othermod/DPI-Topper-3/boards/1.0.1/sch/sch.png

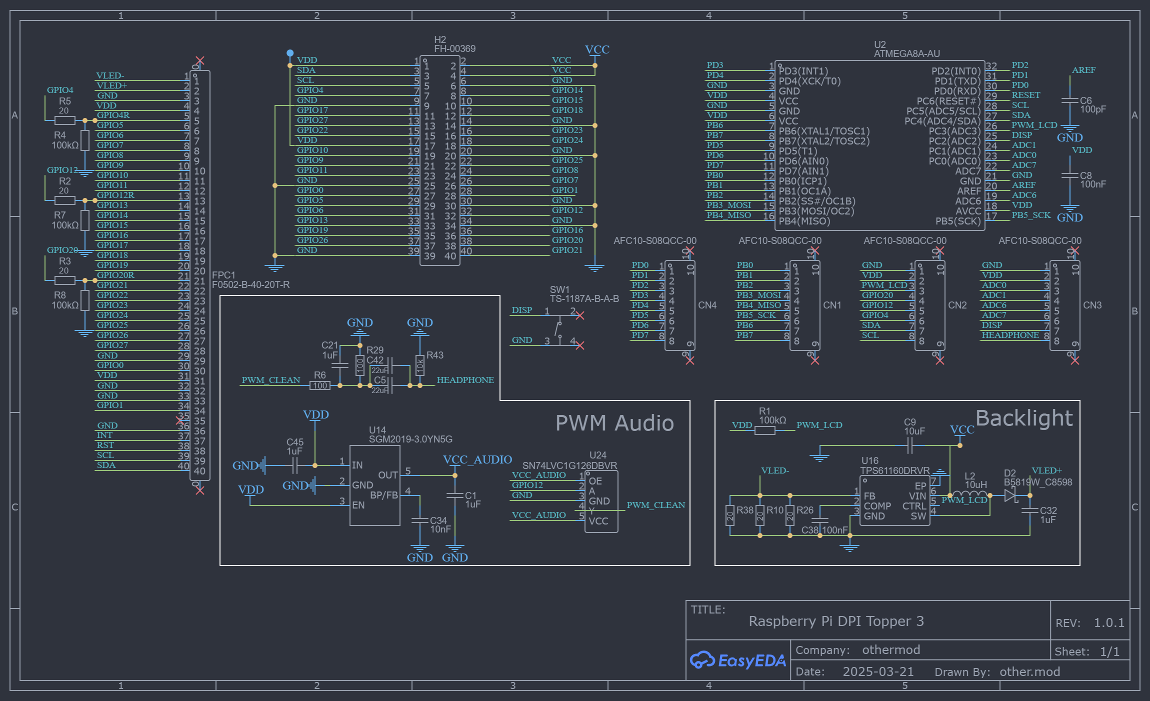
boards/1.0.1/sch/sch.png
