othermod/DPI-Topper-3/boards/1.0/pcb/variant_display.png

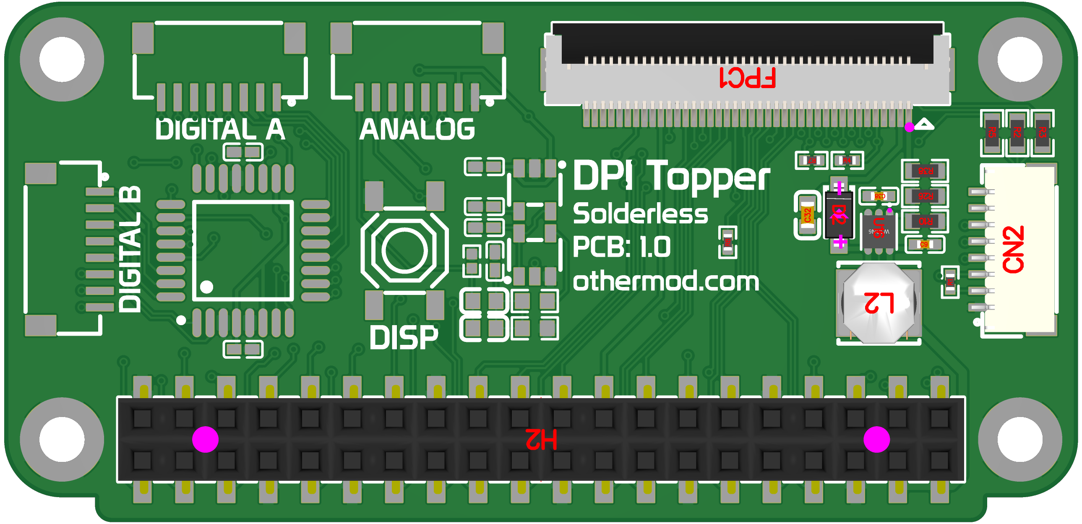
boards/1.0/pcb/variant_display.png
