othermod/DPI-Topper-3/boards/1.0/pcb/variant_gamepad.png

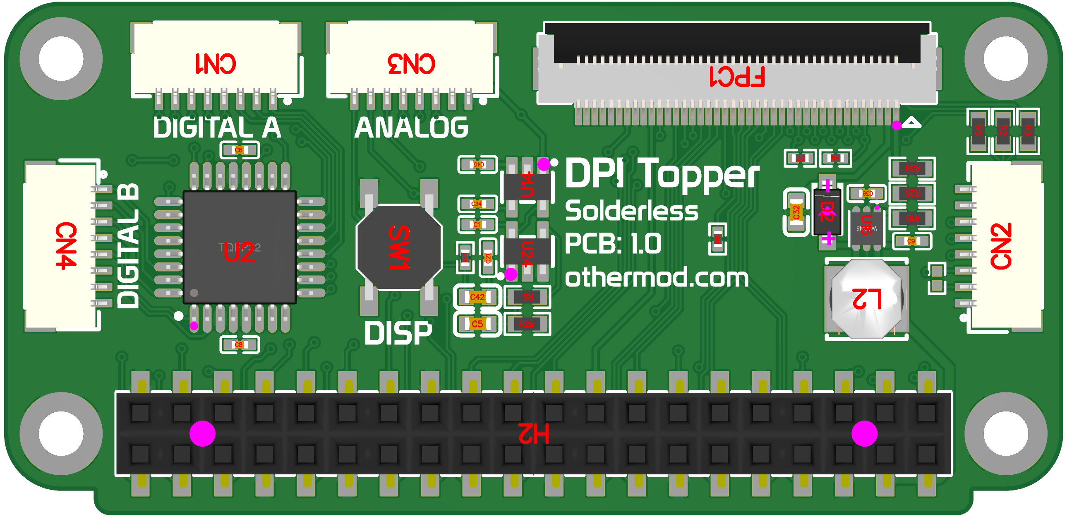
boards/1.0/pcb/variant_gamepad.png
