othermod/DPI-Topper-3/boards/1.0/pcb/bom/bom_display.csv

ID | Name | Designator | Footprint | Quantity | Manufacturer Part | Manufacturer | Supplier | Supplier Part | Price
1 | 100kΩ | R4,R7,R8,R1 | R0402 | 4 | 0402WGF1003TCE | UNI-ROYAL(厚声) | LCSC | C25741 | 0.001
3 | 20 | R2,R3,R5,R10,R26,R38 | R0603 | 6 | 0603WAF200JT5E | UNI-ROYAL(厚声) | LCSC | C22950 | 0.001
11 | 100nF | C38 | C0402 | 1 | CL05B104KO5NNNC | SAMSUNG(三星) | LCSC | C1525 | 0.001
12 | F0502-B-40-20T-R | FPC1 | FPC-SMD_40P-P0.50_L5.9-W24.4 | 1 | F0502-B-40-20T-R | XFCN(兴飞) | LCSC | C481222 | 0.135
15 | 10uF | C9 | C0402 | 1 | CL05A106MQ5NUNC | SAMSUNG(三星) | LCSC | C15525 | 0.004
16 | 1uF | C32 | C0603 | 1 | CL10A105KB8NNNC | SAMSUNG(三星) | LCSC | C15849 | 0.004
17 | B5819W_C8598 | D2 | SOD-123_L2.7-W1.6-LS3.7-RD-1 | 1 | B5819W SL | CJ(江苏长电/长晶) | LCSC | C8598 | 0.026
18 | 10uH | L2 | IND-SMD_L4.9-W4.9_NRS50XX | 1 | NRS5010T100MMGF | TAIYO YUDEN(太诱) | LCSC | C222896 | 0.185
19 | TPS61160DRVR | U16 | WSON-6_L2.0-W2.0-P0.65-TL-EP | 1 | TPS61160DRVR | TI(德州仪器) | LCSC | C165143 | 0.497
20 | AFC10-S08QCC-00 | CN2 | CONN-SMD_AFC10-S08QCC-00 | 4 | AFC10-S08QCC-00 | JS(钜硕电子) | LCSC | C395305 | 0.104
21 | FH-00369 | H2 | CONN-SMD_FH-00369 | 1 | FH-00369 | Liansheng(连盛) | LCSC | C2685115 | 0.648
