othermod/DPI-Topper-3/boards/1.0.1/pcb/soldered/bom/bom_gamepad_soldered.csv

ID | Name | Designator | Footprint | Quantity | Manufacturer Part | Manufacturer | Supplier | Supplier Part | Price
1 | 100kΩ | R4,R7,R8 | R0402 | 4 | 0402WGF1003TCE | UNI-ROYAL(厚声) | LCSC | C25741 | 0.001
2 | 1uF | C45,C1,C21 | C0402 | 3 | CL05A105KA5NQNC | SAMSUNG(三星) | LCSC | C52923 | 0.003
3 | 20 | R2,R3,R5,R10,R26,R38 | R0603 | 6 | 0603WAF200JT5E | UNI-ROYAL(厚声) | LCSC | C22950 | 0.001
4 | 22uF | C5,C42 | C0603 | 2 | CL10A226MQ8NRNC | SAMSUNG(三星) | LCSC | C59461 | 0.008
5 | 10nF | C34 | C0402 | 1 | CL05B103KB5NNNC | SAMSUNG(三星) | LCSC | C15195 | 0.001
6 | 100 | R6,R29 | R0603 | 2 | 0603WAF1000T5E | UNI-ROYAL(厚声) | LCSC | C22775 | 0.001
7 | 10k | R43 | R0402 | 1 | 0402WGF1002TCE | UNI-ROYAL(厚声) | LCSC | C25744 | 0.001
8 | SGM2019-3.0YN5G | U14 | SOT-23-5_L3.0-W1.7-P0.95-LS2.8-BR | 1 | SGM2019-3.0YN5G/TR | SGMICRO(圣邦微) | LCSC | C57079 | 0.074
9 | SN74LVC1G126DBVR | U24 | SOT-23-5_L3.0-W1.7-P0.95-LS2.8-BR | 1 | SN74LVC1G126DBVR | TI(德州仪器) | LCSC | C7834 | 0.057
10 | TS-1187A-B-A-B | SW1 | SW-SMD_4P-L5.1-W5.1-P3.70-LS6.5-TL-2 | 1 | TS-1187A-B-A-B | XKB Connectivity(中国星坤) | LCSC | C318884 | 0.02
11 | 100nF | C38 | C0402 | 1 | CL05B104KO5NNNC | SAMSUNG(三星) | LCSC | C1525 | 0.001
12 | F0502-B-40-20T-R | FPC1 | FPC-SMD_40P-P0.50_L5.9-W24.4 | 1 | F0502-B-40-20T-R | XFCN(兴飞) | LCSC | C481222 | 0.135
13 | 100pF | C6 | C0402 | 1 | 0402CG101J500NT | FH(风华) | LCSC | C1546 | 0.001
14 | 100nF | C8 | C0402 | 1 | CL05B104KB54PNC | SAMSUNG(三星) | LCSC | C307331 | 0.005
15 | 10uF | C9 | C0402 | 1 | CL05A106MQ5NUNC | SAMSUNG(三星) | LCSC | C15525 | 0.004
16 | 1uF | C32 | C0603 | 1 | CL10A105KB8NNNC | SAMSUNG(三星) | LCSC | C15849 | 0.004
17 | B5819W_C8598 | D2 | SOD-123_L2.7-W1.6-LS3.7-RD-1 | 1 | B5819W SL | CJ(江苏长电/长晶) | LCSC | C8598 | 0.026
18 | 10uH | L2 | IND-SMD_L4.9-W4.9_NRS50XX | 1 | NRS5010T100MMGF | TAIYO YUDEN(太诱) | LCSC | C222896 | 0.185
19 | TPS61160DRVR | U16 | WSON-6_L2.0-W2.0-P0.65-TL-EP | 1 | TPS61160DRVR | TI(德州仪器) | LCSC | C165143 | 0.497
20 | AFC10-S08QCC-00 | CN2,CN4,CN3,CN1 | CONN-SMD_AFC10-S08QCC-00 | 4 | AFC10-S08QCC-00 | JS(钜硕电子) | LCSC | C395305 | 0.104
22 | ATMEGA8A-AU | U2 | TQFP-32_L7.0-W7.0-P0.80-LS9.0-BL | 1 | ATMEGA8A-AU | MICROCHIP(美国微芯) | LCSC | C16190 | 2.03
