othermod/DPI-Topper-3/boards/1.0.1/pcb/soldered/variant_display_soldered.png

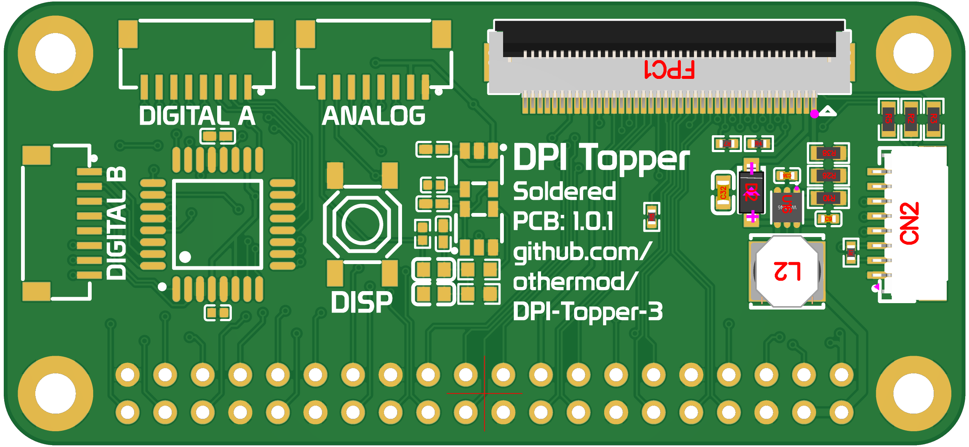
boards/1.0.1/pcb/soldered/variant_display_soldered.png
