othermod/DPI-Topper-3/boards/1.0.1/pcb/solderless/variant_display_solderless.png

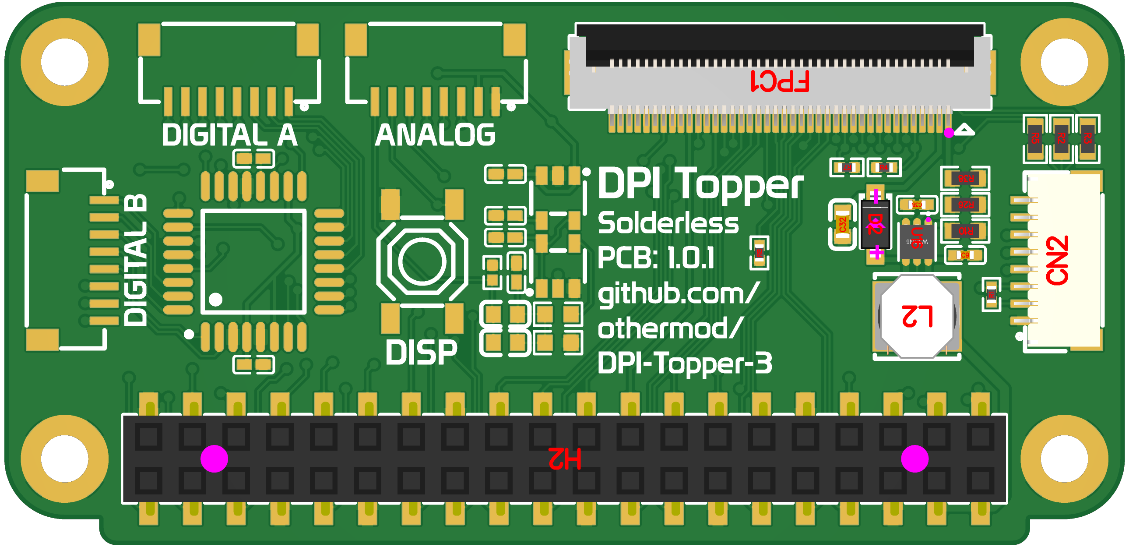
boards/1.0.1/pcb/solderless/variant_display_solderless.png
