othermod/DPI-Topper-3/(list of files, drawings)

Other design files:
boards/1.0.1/pcb/solder/pcb_easyeda.json
boards/1.0.1/pcb/soldered/pcb_easyeda_soldered.json
boards/1.0.1/pcb/solderless/pcb_easyeda_solderless.json
boards/1.0.1/sch/sch_easyeda.json
boards/1.0/pcb/pcb_easyeda.json
boards/1.0/pcb/sch_easyeda.json
