othermod/DPI-Topper-3/atmega/bootloader/bootloader.c

/*
 * TWI/I2C Bootloader for ATmega8
 * Concept inspired by twiboot by Olaf Rempel <razzor@kopf-tisch.de>
 */

#include <avr/io.h>
#include <avr/boot.h>
#include <avr/pgmspace.h>

#define BOOTLOADER_VERSION          0x01
#define TWI_ADDRESS                 0x29

/* Timer0: F_CPU / 1024, free-running overflow period = 256 * 1024 / F_CPU */
#define TIMER_DIVISOR               1024
#define TIMER_OVF_PER_SEC           (F_CPU / ((uint32_t)TIMER_DIVISOR * 256))

/* I2C protocol commands */
#define CMD_READ_INFO               0x01
#define CMD_WRITE_PAGE              0x03  /* page number byte precedes the 64 data bytes */
#define CMD_FINALIZE                0x05

/* TWI slave receiver status codes (ATmega8 datasheet table 22-2) */
#define TWI_SR_SLA_ACK              0x60    /* SLA+W received, ACK returned */
#define TWI_SR_DATA_ACK             0x80    /* data received, ACK returned */
#define TWI_SR_DATA_NACK            0x88    /* data received, NACK returned */
#define TWI_SR_STOP                 0xA0    /* STOP or repeated START received */

/* TWI slave transmitter status codes (ATmega8 datasheet table 22-3) */
#define TWI_ST_SLA_ACK              0xA8    /* SLA+R received, ACK returned */
#define TWI_ST_DATA_ACK             0xB8    /* data sent, ACK received */
#define TWI_ST_DATA_NACK            0xC0    /* data sent, NACK received */
#define TWI_ST_LAST_ACK             0xC8    /* last data byte sent, ACK received */

/* bootloader run modes */
#define BL_HOLD                     0x00
#define BL_JUMP_APP                 0x01

/* Verification status codes (bit patterns with Hamming distance 8 from each other) */
#define VERIFY_PENDING              0x00
#define VERIFY_FAILED               0x55
#define VERIFY_PASSED               0xAA

/* TWI ACK control helpers */
#define TWI_CLEAR_ACK(ctrl)         ((ctrl) &= ~(1<<TWEA))
#define TWI_SET_ACK(ctrl)           ((ctrl) |=  (1<<TWEA))

/* Pin definitions */
#define LCD_CONTROL                 (1<<PC3)
#define BTN_DISP                    (1<<PC2)

static uint8_t          bl_mode                  = BL_HOLD;
static uint8_t          page_buf[SPM_PAGESIZE];
static uint16_t         flash_addr;
static volatile uint8_t page_write_pending       = 0;
static volatile uint8_t page_write_ready         = 0;
static volatile uint8_t checksum_verify_pending  = 0;
static uint8_t          verify_status            = VERIFY_PENDING;
static uint8_t          info_bytes[6];
static uint8_t          info_checksum[3];


static void write_flash_page(void)
{
    uint16_t pagestart = flash_addr;
    uint16_t fill_addr = flash_addr;
    uint8_t  i;

    boot_page_erase(pagestart);
    boot_spm_busy_wait();

    for (i = 0; i < SPM_PAGESIZE; i += 2)
    {
        uint16_t word = page_buf[i] | ((uint16_t)page_buf[i + 1] << 8);
        boot_page_fill(fill_addr, word);
        fill_addr += 2;
    }

    boot_page_write(pagestart);
    boot_spm_busy_wait();
    boot_rww_enable();
}


static void update_info_checksum(void)
{
    uint8_t sum1 = 0, sum2 = 0, xor = 0, i;
    for (i = 0; i < 6; i++)
    {
        sum1 += info_bytes[i];
        sum2 += sum1;
        xor  ^= info_bytes[i];
    }
    info_checksum[0] = sum1;
    info_checksum[1] = sum2;
    info_checksum[2] = xor;
}


/* Checksum covers all app flash bytes except the final 3, which store the checksum itself. */
static void compute_flash_checksum(uint8_t *f16_a, uint8_t *f16_b, uint8_t *xorsum)
{
    uint8_t  sum1 = 0, sum2 = 0, xor = 0;
    uint16_t i;
    for (i = 0; i < BOOTLOADER_START - 3; i++)
    {
        uint8_t b = pgm_read_byte_near(i);
        sum1 += b;
        sum2 += sum1;
        xor  ^= b;
    }
    *f16_a  = sum1;
    *f16_b  = sum2;
    *xorsum = xor;
}


/* Returns 1 if the embedded checksum at the top of app flash matches the computed value. */
static uint8_t flash_verify_checksum(void)
{
    uint8_t f16_a, f16_b, xorsum;
    compute_flash_checksum(&f16_a, &f16_b, &xorsum);
    return (f16_a  == pgm_read_byte_near(BOOTLOADER_START - 3) &&
            f16_b  == pgm_read_byte_near(BOOTLOADER_START - 2) &&
            xorsum == pgm_read_byte_near(BOOTLOADER_START - 1));
}


static void twi_handle(void)
{
    static uint8_t cmd = 0;
    /* byte_cnt counts received bytes in the RX path and sent bytes in the TX path */
    static uint8_t byte_cnt;

    uint8_t twi_ctrl   = TWCR;
    uint8_t twi_status = TWSR & 0xF8;

    switch (twi_status)
    {
        case TWI_SR_SLA_ACK:
            byte_cnt           = 0;
            page_write_pending = 0;
            page_write_ready   = 0;
            break;

        case TWI_SR_DATA_ACK:
        {
            uint8_t rx_data = TWDR;

            if (byte_cnt == 0)
            {
                cmd = rx_data;
                switch (cmd)
                {
                    /* valid commands; no immediate action on receipt of command byte */
                    case CMD_READ_INFO:
                    case CMD_WRITE_PAGE:
                    case CMD_FINALIZE:
                        break;

                    default:
                        TWI_CLEAR_ACK(twi_ctrl);
                        break;
                }
            }
            else
            {
                switch (cmd)
                {
                    case CMD_WRITE_PAGE:
                        if (byte_cnt == 1)
                        {
                            /* first byte after command is the page number */
                            if (rx_data >= (BOOTLOADER_START / SPM_PAGESIZE))
                                TWI_CLEAR_ACK(twi_ctrl);
                            else
                                flash_addr = (uint16_t)rx_data * SPM_PAGESIZE;
                        }
                        else
                        {
                            uint8_t buf_pos = byte_cnt - 2;
                            page_buf[buf_pos] = rx_data;
                            if (buf_pos >= (SPM_PAGESIZE - 1))
                            {
                                page_write_pending = 1;
                                TWI_CLEAR_ACK(twi_ctrl);
                            }
                        }
                        break;

                    case CMD_FINALIZE:
                        /* no data bytes expected; NACK any extra */
                        TWI_CLEAR_ACK(twi_ctrl);
                        break;

                    default:
                        break;
                }
            }

            byte_cnt++;
            break;
        }

        /* master sent more data than expected; treat as end of transaction */
        case TWI_SR_DATA_NACK:
            /* fall through */

        case TWI_SR_STOP:
            if (page_write_pending)
            {
                /* STOP received with a pending write: set page_write_ready so the
                 * main loop starts the flash write only AFTER this TWINT is cleared.
                 * This prevents the ATmega from holding SCL during the 4.5ms
                 * erase+program cycle, which triggers the BCM2835 clock-stretch bug. */
                TWI_CLEAR_ACK(twi_ctrl);
                page_write_ready = 1;
            }
            else
            {
                if (cmd == CMD_FINALIZE && byte_cnt >= 1)
                {
                    checksum_verify_pending = 1;
                    /* Keep TWEA cleared while compute_flash_checksum runs (~7ms)
                     * in the main loop, for the same reason as above. */
                    TWI_CLEAR_ACK(twi_ctrl);
                }
                byte_cnt = 0;
                if (!checksum_verify_pending)
                    TWI_SET_ACK(twi_ctrl);
            }
            break;

        case TWI_ST_SLA_ACK:
            byte_cnt = 0;
            /* fall through */

        case TWI_ST_DATA_ACK:
        {
            uint8_t tx_data = 0xFF;

            switch (cmd)
            {
                case CMD_READ_INFO:
                    if (byte_cnt < 6)
                        tx_data = info_bytes[byte_cnt];
                    else if (byte_cnt < 9)
                        tx_data = info_checksum[byte_cnt - 6];
                    if (byte_cnt == 8)
                        TWI_CLEAR_ACK(twi_ctrl);
                    break;

                default:
                    break;
            }

            TWDR = tx_data;
            byte_cnt++;
            break;
        }

        case TWI_ST_DATA_NACK:
        case TWI_ST_LAST_ACK:
            TWI_SET_ACK(twi_ctrl);
            break;

        default:
            /* unexpected TWI state; set TWSTO to reset the bus */
            twi_ctrl |= (1<<TWSTO);
            break;
    }

    TWCR = (1<<TWINT) | twi_ctrl;
}


void init1(void) __attribute__((naked, section(".init1")));
void init1(void)
{
    asm volatile ("clr __zero_reg__");
    SP = RAMEND;
}


int main(void) __attribute__((OS_main, section(".init9")));
int main(void)
{
    /* explicitly re-init critical state rather than relying on .bss clearing */
    bl_mode            = BL_HOLD;
    page_write_pending = 0;
    page_write_ready   = 0;

    /* output, initially low, driven high when bootloader holds active */
    DDRC  |=  LCD_CONTROL;
    PORTC &= ~LCD_CONTROL;

    /* input with pull-up, held low at power-on forces bootloader to stay active */
    DDRC  &= ~BTN_DISP;
    PORTC |=  BTN_DISP;

    /* Timer0: F_CPU / 1024, free-running */
    TCCR0 = (1<<CS02) | (1<<CS00);

    /* TWI: set slave address, enable auto-ACK */
    TWAR  = (TWI_ADDRESS << 1);
    TWCR  = (1<<TWEA) | (1<<TWEN);

    /* --- BOOT ENTRY LOGIC --- */
    if (PINC & BTN_DISP)
    {
        /* Button not pressed: boot app only if embedded checksum is valid */
        if (flash_verify_checksum())
            bl_mode = BL_JUMP_APP;
    }
    else
    {
        /* Button pressed: wait up to 1 second for release.
         * Releasing early boots the app (if checksum valid); holding the full second stays in bootloader. */
        uint8_t ovf_count = 0;
        while (ovf_count < (uint8_t)TIMER_OVF_PER_SEC)
        {
            while (!(TIFR & (1<<TOV0)));
            TIFR = (1<<TOV0);
            ovf_count++;

            if (PINC & BTN_DISP)
            {
                if (flash_verify_checksum())
                    bl_mode = BL_JUMP_APP;
                break;
            }
        }
    }

    if (bl_mode == BL_HOLD)
        PORTC |= LCD_CONTROL;

    info_bytes[0] = SIGNATURE_0;
    info_bytes[1] = SIGNATURE_1;
    info_bytes[2] = SIGNATURE_2;
    info_bytes[3] = BOOTLOADER_VERSION;
    info_bytes[4] = (uint8_t)(BOOTLOADER_START / SPM_PAGESIZE);
    info_bytes[5] = VERIFY_PENDING;
    update_info_checksum();

    /* --- MAIN LOOP (I2C programming) --- */
    while (bl_mode == BL_HOLD)
    {
        if (TWCR & (1<<TWINT))
            twi_handle();

        if (page_write_ready)
        {
            page_write_ready   = 0;
            page_write_pending = 0;
            write_flash_page();
            TWCR = (1<<TWEN) | (1<<TWEA);
        }

        if (checksum_verify_pending)
        {
            checksum_verify_pending = 0;
            if (flash_verify_checksum())
            {
                verify_status = VERIFY_PASSED;
                bl_mode = BL_JUMP_APP;
            }
            else
                verify_status = VERIFY_FAILED;
            info_bytes[5] = verify_status;
            update_info_checksum();
            TWCR = (1<<TWEN) | (1<<TWEA);
        }
    }

    TWCR  = 0x00;
    TCCR0 = 0x00;

    ((void (*)(void))0x0000)();
    __builtin_unreachable();
}
