othermod/DPI-Topper-3/(commit log)

2025-01-12 add kernel driver for gamepad
2025-01-12 add overlay for display and pin configuration
2025-01-12 add touch screen overlay config
    [config.txt]
2025-01-12 add optional userspace driver for touch
2025-03-23 add pcbs
    [bom_full.csv, bom_minimal.csv, pcb_easyeda.json, pick_and_place_full.csv, pick_and_place_minimal.csv, sch_easyeda.json]
2025-03-24 add pcb details
2025-03-24 note ability to update brightness over i2c
2025-08-24 include version history on boards readme
2025-11-11 reorganize pcb files
    [bom_full.csv, bom_minimal.csv, pick_and_place_full.csv, pick_and_place_minimal.csv]
2025-11-13 update firmware
    Add the ability to turn off the backlight using i2c.
    Add fade effect when enabling and disabling the backlight.
2025-11-13 add script to flash fuses and firmware
2025-11-13 remove unused folder
    [config.txt]
2025-12-29 forgot to update config for new i2c command
2025-12-29 add gamepad driver
2026-01-17 rename and rearrange board files
    [bom_basic.csv, bom_full.csv, bom_gamepad.csv, bom_minimal.csv, pcb_easyeda.json, pick_and_place_basic.csv, pick_and_place_full.csv, pick_and_place_gamepad.csv]
2026-01-17 add drivers
2026-01-17 remove unused files
    [bom_full.csv, bom_minimal.csv, pick_and_place_full.csv, pick_and_place_minimal.csv]
2026-03-11 change pin directions using i2c
2026-03-11 report pin directions in i2c data
2026-03-11 make pin direction changes a single i2c command
2026-03-12 update board naming, add new pics
    [bom_display.csv, bom_display_soldered.csv, bom_display_solderless.csv, bom_gamepad_soldered.csv, bom_gamepad_solderless.csv, pcb_easyeda_soldered.json, pcb_easyeda_solderless.json, pick_and_place_display.csv]
2026-03-18 add custom i2c bootloader
2026-03-18 add the ability to backup the firmware currently on the atmega
2026-03-19 allow brightness button to force bootloader mode
2026-03-19 modify pin direction reporting over i2c
2026-03-19 update readme to include some uses for the board
2026-03-26 tweak i2c commands and data to avoid incorrect states being read
    [firmware.ino]
2026-03-26 update the reset command value
    [update_firmware.c]
2026-03-27 add makefile for rpi i2c firmware flashing utility
2026-04-20 add command to write pin status to eeprom
    previously happened on each pin change, and this may wear out the eeprom if its hammered
2026-04-22 update i2c command
2026-04-23 fix arduino path
2026-04-29 update backlight control utility name to prevent confusion
    [backlight-display.c]
2026-04-30 replace insecure arduino-cli install, add lint job, pin actions
    - Replace `curl | sh` arduino-cli install with `arduino/setup-arduino-cli@v2`
    - Add `~/.arduino15` cache to speed up repeated ATmega builds
    - Pin `softprops/action-gh-release@v2` to SHA 3bb1273 (v2.6.2)
    - Pin `actions/checkout@v4` and `actions/upload-artifact@v4` to SHAs in build-atmega.yml
    - Add dedicated `.github/workflows/lint.yml` for actionlint on every push/PR
2026-04-30 Revert "replace insecure arduino-cli install, add lint job, pin actions"
    This reverts commit 4aa07faeb0119ed07d47c5415f144323cc0a4ce6.
2026-06-08 add the ability to read all pin state info
2026-06-10 ensure mode and page initialize correctly on a warm boot
    [bootloader.c]
2026-06-10 explicit critical state init and harden app jump
    Add explicit assignments for bl_mode, page_write_pending, and page_write_ready at the top of main() so warm resets (external reset, watchdog) cannot leave stale values that bypass the hold loop or trigger a spurious flash write. Replace the jump_to_app global function pointer with an inline cast at the call site, removing a dependency on .bss state. Update the startup comment to accurately reflect that .bss clearing does occur. Fix incorrect pin labels in comments (PC4/PC3 → PC3/PC2).
    [bootloader.c]
2026-06-24 add gsl1860f touch driver and firmware
2026-06-24 fix incorrect touch panel name
    [gsl1680f.c]
2026-06-25 add averaging to fix jitter, add calibration offsets
    [gsl1680f.c]
